mamunul/watertankmonitor/(threads)

Thread 1 (2022-09-21):

add sleep in transmitter

mamunul, 2022-09-21:

mamunul, 2022-10-10:
wake once in every minute and send data, then sleep again. if water level is 4 and motor is on or level is 1 and motor is off then send data in every 15 seconds.

mamunul, 2022-10-11:
For some unknown reason touching the external timer2 crystal only wakes up cpu from power save mode.

mamunul, 2022-12-31:
sleep time is unstable for some reason. after using 32768Hz Crystal without capacitor interval is consistent.

mamunul, 2023-01-02:
15seconds sleep is implemented with 32K crystal un atmega8.

Thread 4 (2022-09-23):

Add test transmitter and receiver to check distance

mamunul, 2022-09-23:
Implement a simplest transmitter using atmega8 and a receiver using esp8266. and take it to the place where it is intended to use so that it can be verified the distance will be ok to communicate wirelessly with reliability.

mamunul, 2022-09-23:
List of the things need to take for testing.

- atmega8
- mini breadboard
- rf transmitter
- 3 battery holder
- esp8266
- rf receiver

mamunul, 2022-10-09:
Testing is completed. It works :). Receiver was connected with my computer in our dining room. Transmitter was moving from receiver to the 3rd floor near water tank. There was no missing information in the receiver, as it prints counter value serially which is received from transmitter.

Closed 2023-06-13.

Thread 7 (2023-01-14):

reduce power consumption in transmitter

mamunul, 2023-01-14:
Now after enabling 15 seconds of power save mode, new battery runs for 2 days only. in every minute there is 4 transmutation and in every transmission there 4 repeated messages. SO in total 16 message per minute. in each message around 15mA is consuming. per minute around 5mA. For normal battery(250mAH) it will withstand for 50 hours only.

**ways to reduce power consumption**

- send 2-3 messages per minute
- reduce avr clock speed to 1MHz from 8MHz

mamunul, 2023-01-15:
add following in transmitter

`#define RCSwitchDisableReceiving`

reduce transmission repeat to 2

` this->setRepeatTransmit(2);`

mamunul, 2023-01-16:
https://arduino.stackexchange.com/questions/50733/is-there-a-way-to-disable-modules-like-adc-without-a-sleep-mode

mamunul, 2023-01-16:
test power consumption using oscilloscope and report here with applied configuration for future reference.

mamunul, 2023-01-19:
transmission repeat to 2 was not working so it kept at 5 and now working.

mamunul, 2023-06-13:
put the atmega in deep-sleep using timer circuit to reduce power more.

mamunul, 2023-10-11:
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

Where:

Bl = Battery lifetime in hours
Bc= Battery capacity in mAh
Ia = Device current consumption when awake in mA
Is = Device current consumption when in Sleep Mode in mA
ta = Time spent awake in seconds (per cycle)
ts = Time spent in Sleep Mode in seconds (per cycle)

mamunul, 2023-10-12:
disable wdt which will keep 1uA consumption down from 15uA

#include <avr/wdt.h>

 wdt_disable();

mamunul, 2023-10-20:
after applying tpl5111 and power down mode, sleep time current consumption is around 11uA and active time consumption is 10mA

mamunul, 2023-10-20:
1. water tank requires around 12minute to fill up.
2.

mamunul, 2023-10-28:
test timer using esp32 interrupt codes to count rather checking in oscilloscope.

mamunul, 2023-10-29:
improve sending performance by reducing repetitive data sending. Check minimum time and similar height.

mamunul, 2023-11-07:
after applying tpl5111, power consumption is significantly reduced, as on sleep transmitter and sensor not taking consuming any power.

mamunul, 2023-11-07:
Now if the circuit don't work under 4 voltage, then a voltage regulator - TPS6320 may be needed to juice out the battery until it is completely depleted.

mamunul, 2023-11-12:
battery is depleted after around 15days. so more optimization is necessary.

mamunul, 2023-11-13:
reduce transmit repetition number and remove delay after sending.
transmit if sensed water level has absolute difference of >= 5cm with the last measured water level, otherwise don't transmit data.

mamunul, 2023-11-14:
after using avr io for powering distance sensor, power consumption is saved in <1uA in sleep time and active time current is 16mA.

mamunul, 2023-11-15:
problems are solved.
to activate sensor power using io, it requires a delay after writing high on the pin - delay(20);less than 18ms not working.
and transmit repetition must be minimum 3, otherwise it won't work.

Now active max current is 8.6mA.

mamunul, 2023-11-15:
received data, when continuous transmission is active(without any sleep or delay).

21:09:02:214 -> received: 168
21:09:02:214 -> 168
21:09:02:362 -> received: 168
21:09:02:362 -> 168
21:09:02:510 -> received: 168
21:09:02:510 -> 168
21:09:02:657 -> received: 168
21:09:02:657 -> 168
21:09:02:805 -> received: 170
21:09:02:805 -> 170
21:09:02:953 -> received: 170
21:09:02:953 -> 170
21:09:03:101 -> received: 170
21:09:03:101 -> 170
21:09:03:248 -> received: 170
21:09:03:248 -> 170
21:09:03:396 -> received: 170
21:09:03:396 -> 170
21:09:03:544 -> received: 170
21:09:03:544 -> 170
21:09:03:691 -> received: 170

Closed 2023-12-12.

Thread 8 (2023-01-19):

add some missing feature in receiver

mamunul, 2023-01-19:
add following feature both in schema and firmware
- jumper to disable/enable buzzer
- button to make buzzer silent
- relay bypass switch so manual on off works
- activate buzzer when tank is empty
- auto shutoff the switch when tank is full

5pins-led
1 INT Pin - receiver
1 INT Pin - relay on/off button(stop buzzer)
1 pin - buzzer out
1 pin - disable/enable buzzer jumper
1 pin - transmitter red led

mamunul, 2023-11-07:
test the circuit and code in project board

mamunul, 2024-01-11:
features are added and tested

Closed 2024-01-11.

Thread 9 (2023-10-23):

Comparison between atmega328 and stm32F103

mamunul, 2023-10-23:

mamunul, 2023-10-23:
**Naming convention of STM32F103**

STM32F103xx family

mamunul, 2023-10-23:
| CHIP         | CPU                  | Freq  | GPIO | Flash | RAM | VCC | Price |
|--------------|----------------------|-------|------|-------|-----|-----|-------|
| ATMEGA328    | 8-bit RISC           | 20MHz | 23   | 32    | 2K  | 5.0 | 1.35$ |
| STM32F103C6T | 32-bit ARM Cortex-M3 | 72MHz | 37   | 32    | 10K | 3.3 | 0.40$ |
| STM32F103VET | 32-bit ARM Cortex-M3 | 72MHz | 80   | 512   | 64K | 3.3 | 1.24$ |

mamunul, 2023-10-23:
| CHIP         | CPU                  | Deep Sleep  Name | DeepSleep uA | DeepSleep Peripherals                                                   | Medium Sleep Name | Medium Sleep uA | Medium Sleep Peripherals                                           | Active mA                    |
|--------------|----------------------|------------------|--------------|-------------------------------------------------------------------------|-------------------|-----------------|--------------------------------------------------------------------|------------------------------|
| ATMEGA328    | 8-bit RISC           | Powerdown        |              | INT0,INT1 level,Watchdog                                                | powersave         |                 | INT0,INT1 level, Watchdog, Timer                                   | 5mA-8Mhz                     |
| STM32F103C6T | 32-bit ARM Cortex-M3 | Standby          | 2uA          | external reset (NRST pin), IWDG reset, rising edge(WKUP pin), RTC alarm | Stop              | 20uA            | EXTI - 16 external the PVD output,  the RTC alarm,  the USB wakeup | 5mA-8MHz 1mA-1MHz 64Mhz      |
| STM32F103VET | 32-bit ARM Cortex-M3 | Standby          | 2uA          | external reset (NRST pin), IWDG reset, rising edge(WKUP pin), RTC alarm | Stop              | 20uA            | EXTI - 16 external the PVD output,  the RTC alarm,  the USB wakeup | 5mA-8MHz 1mA-1MHz 20mA-64MHz |

Thread 10 (2023-11-15):

study on transceiver

mamunul, 2023-11-15:

mamunul, 2023-11-15:
It is difficult to find a better comparison data on transceiver, random data is collected. According to those data RXB6 is best.

| Model              | VCC     | Imax | Range  | dBm     | Freq   | price      | Tx Module |
|--------------------|---------|------|--------|---------|--------|------------|-----------|
| RXB6               | 3-5.5V  | 6mA  | 15-20m | -116dBm | 433MHz | 2.10$      |           |
| SRX882             |         |      | <5m    |         | 433MHz |            |           |
| xy-mk-5v(MX-RM-5V) | 5V      | 4mA  | <5m    | -105dBm | 433MHz | 0.59$ Pair | FS1000A   |
| RX470              | 2.2V-5V | 2mA  |        |         | 433MHz | 0.96$ pair |           |
| RX500A             |         |      |        |         | 433MHz |            |           |
| RXB8               |         | 10mA |        | -114dBm | 433MHz |            |           |
| RXB12              |         | 4mA  |        | -115dBm | 433MHz |            |           |
| RXB14              |         | 4mA  |        | -115dBm | 433MHz |            |           |

Thread 11 (2023-11-15):

study on distance sensor

mamunul, 2023-11-15:
https://www.dfrobot.com/blog-1491.html

mamunul, 2023-11-15:
https://protosupplies.com/product/jsn-sr04t-v3-0-waterproof-ultrasonic-range-finder/

mamunul, 2023-11-15:
| Model     | VCC      | Imax | Freq | trigger pulse width | Resolution | distance   | angle | Temp Sensor | price |
|-----------|----------|------|------|---------------------|------------|------------|-------|-------------|-------|
| HC-SR04   | 4.5-5.5V | 15mA | 40K  | >=10uS              | 3mm        | 2cm-400cm  | 15 D  | NA          | 0.8$  |
| US-100    | 4.5-5.5V | 3mA  | 40K  | >=10uS              | 1mm        | 2cm-400cm  | 15 D  | Includes    | 1.6$  |
| JSN-SR04T | 3.0-5.5V | 30mA | 40K  | >=20uS              | 1cm        | 23cm-600cm | 37 D  | NA          | 2.8$  |

mamunul, 2023-12-12:
The US-100 Ultrasonic Range Finder is similar to the HC-SR04 and HY-SRF05 that it includes the same pulse-width interface as one option to interface to it.  This interface requires the microcontroller to initiate a ‘ping’ and measure the time it takes for the ping to come back.  Based on that out and back time period and the estimated speed of sound which varies with air temperature, the distance can be calculated.  Because there is tight timing required, the operation tends to be a blocking operation on the microcontroller but it overall works very well.

More interestingly, the US-100 also adds a serial interface.  When using the serial interface, the microcontroller requests that a measurement be taken and the module takes care of sending and timing the return of the received ping.  It also takes a measurement of the air temperature to determine the current speed of sound (speed of sound varies somewhat with the air temperature) and from that calculates the distance to the object and returns that measured distance in millimeters.  Using the serial interface is easier to implement, non-blocking on the microcontroller and provides a little more accuracy.

There is a header jumper on the back of the module.  If the jumper is installed, the module is in serial mode of communication.  If the jumper is removed, the module is in pulse-width mode and control and measurement is handled by the microcontroller.

Thread 13 (2023-12-06):

fix receiver not working after a long time period of working

mamunul, 2023-12-06:
around a day later, receiver stop to react with the received data. And it is verified, data is received by connecting esp8266 with receiver module and viewing the serial monitor in vscode. So the problem is in the avr code.

To check the issue, debug avr in project board with receiver module and usb to serial adapter to monitor serial printed data from vscode.

mamunul, 2024-01-11:
After testing in project board with atmega8, the problem is not occurring any more. So the problem may be in soldering, as it is done in Vero board.

Closed 2024-01-11.
