mamunul/watertankmonitor/CircuitDesign/SmartwaterTank/receiver_mega8_brd.pdf

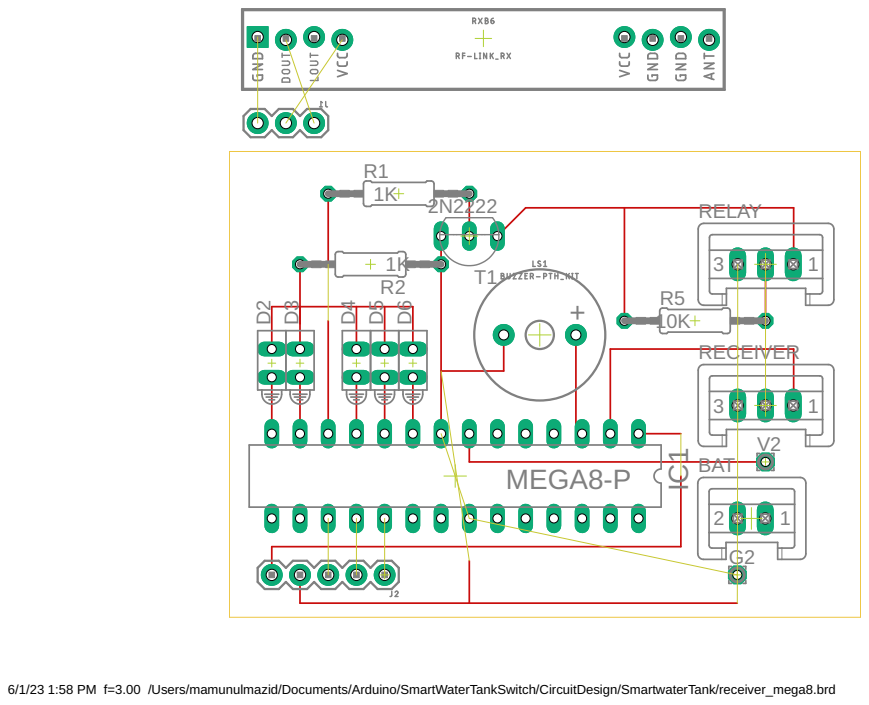
[picture p1: page 1]

6/1/23 1:58 PM f=3.00 /Users/mamunulmazid/Documents/Arduino/SmartWaterTankSwitch/CircuitDesign/SmartwaterTank/receiver_mega8.brd
