mamunul/watertankmonitor/CircuitDesign/SmartwaterTank/receiver_mega8_sch.pdf

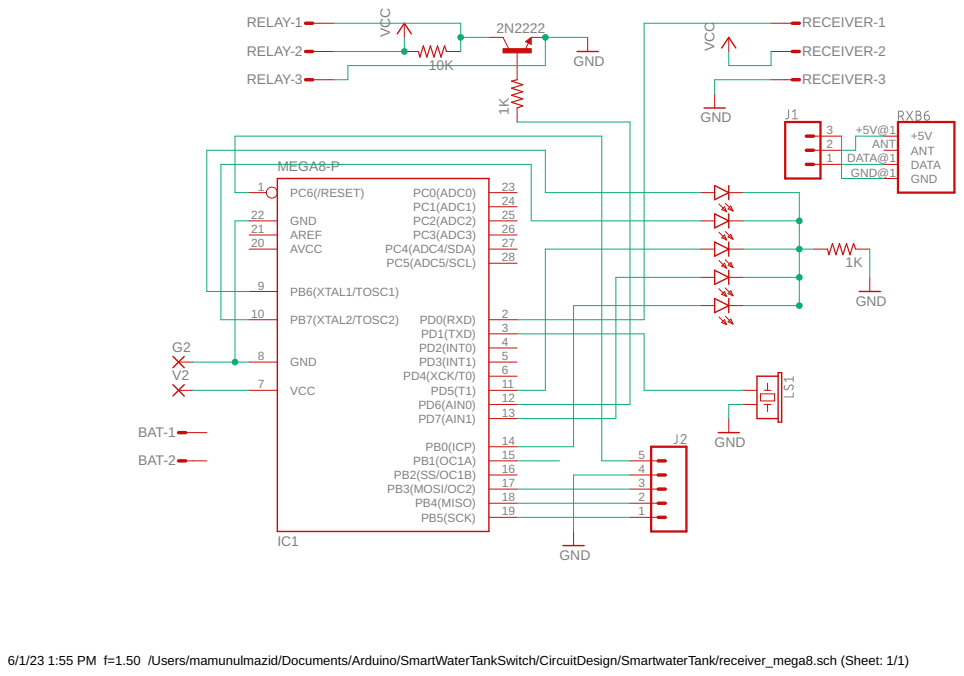
[picture p2: page 1]

6/1/23 1:55 PM f=1.50 /Users/mamunulmazid/Documents/Arduino/SmartWaterTankSwitch/CircuitDesign/SmartwaterTank/receiver_mega8.sch (Sheet: 1/1)
