mamunul/watertankmonitor/CircuitDesign/SmartwaterTank/transmitter_with_sensor_brd.pdf

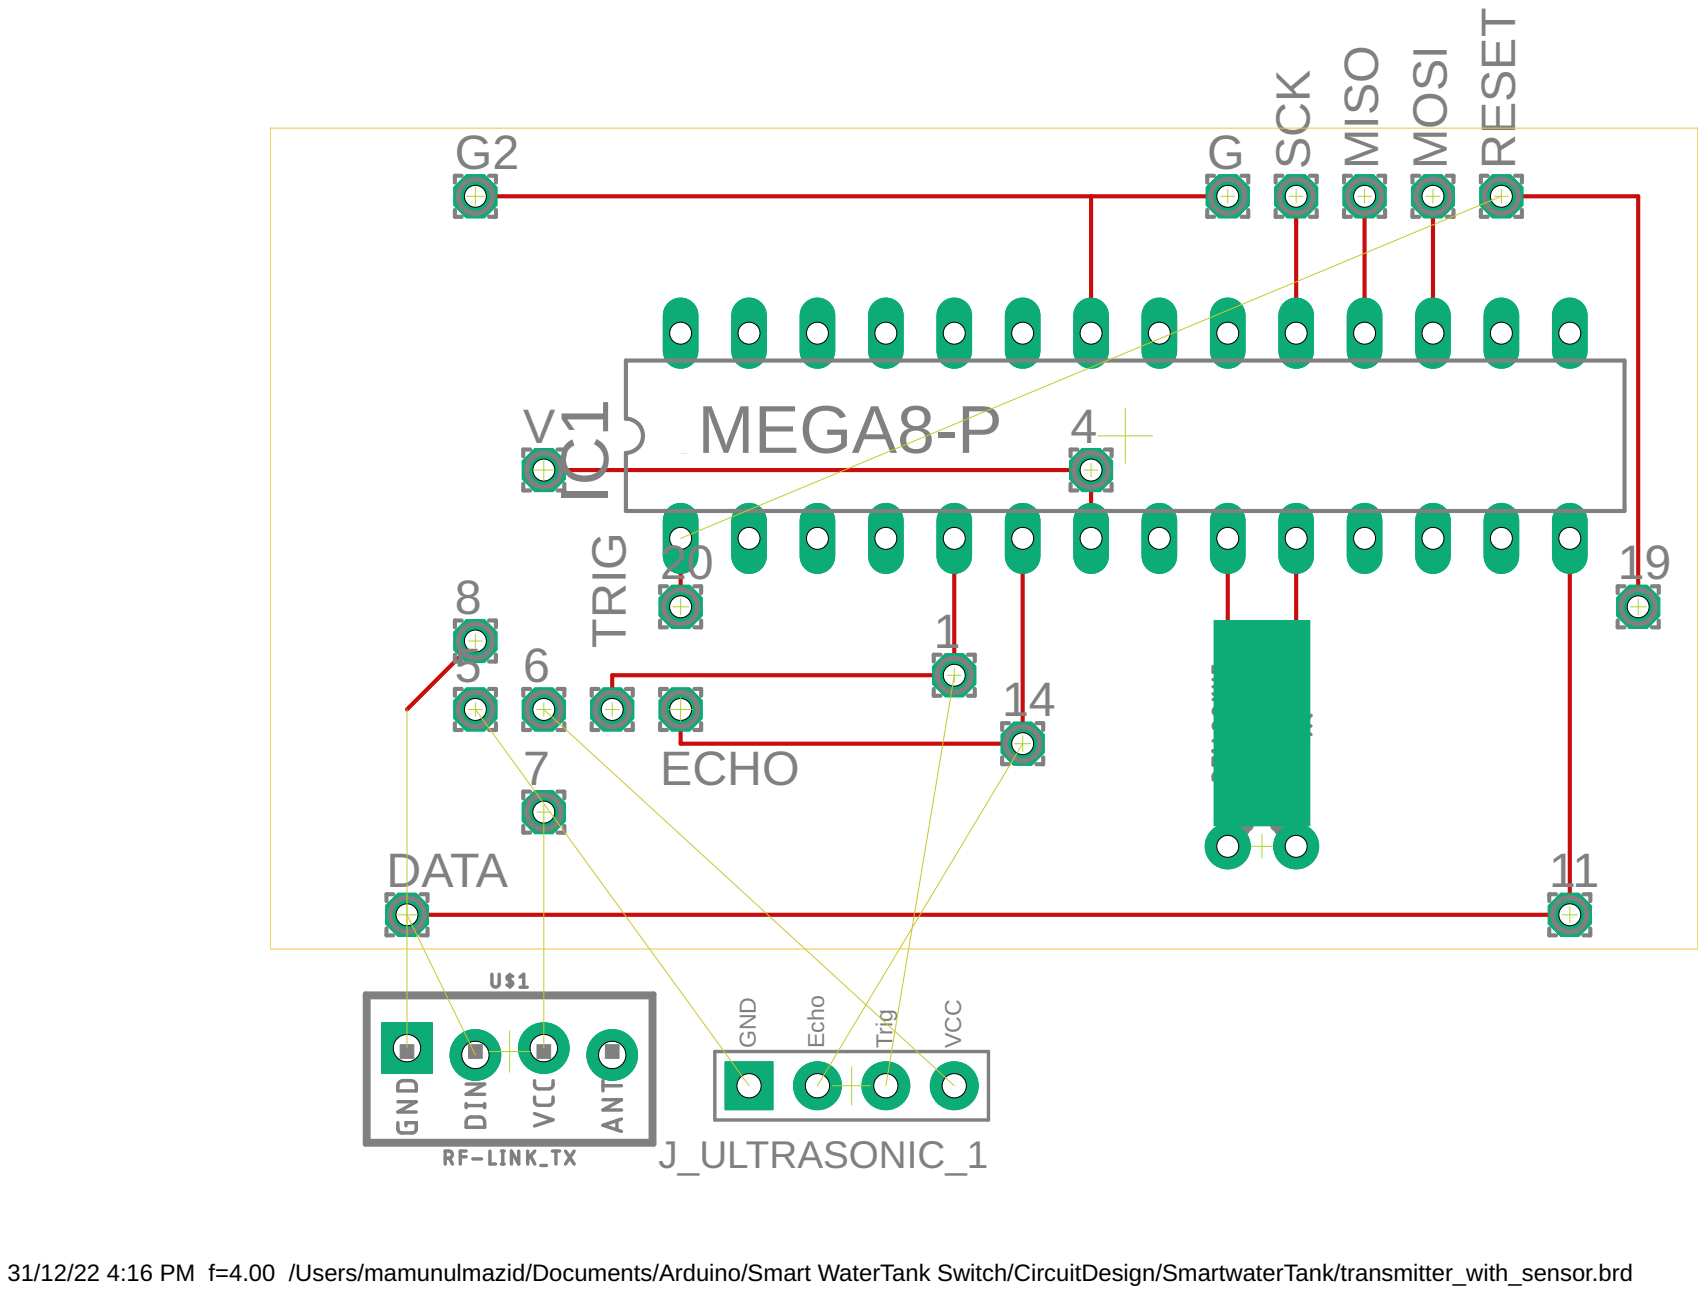
[picture p3: page 1]

31/12/22 4:16 PM f=4.00 /Users/mamunulmazid/Documents/Arduino/Smart WaterTank Switch/CircuitDesign/SmartwaterTank/transmitter_with_sensor.brd
