mamunul/watertankmonitor/CircuitDesign/SmartwaterTank/transmitter_with_sensor_sch.pdf

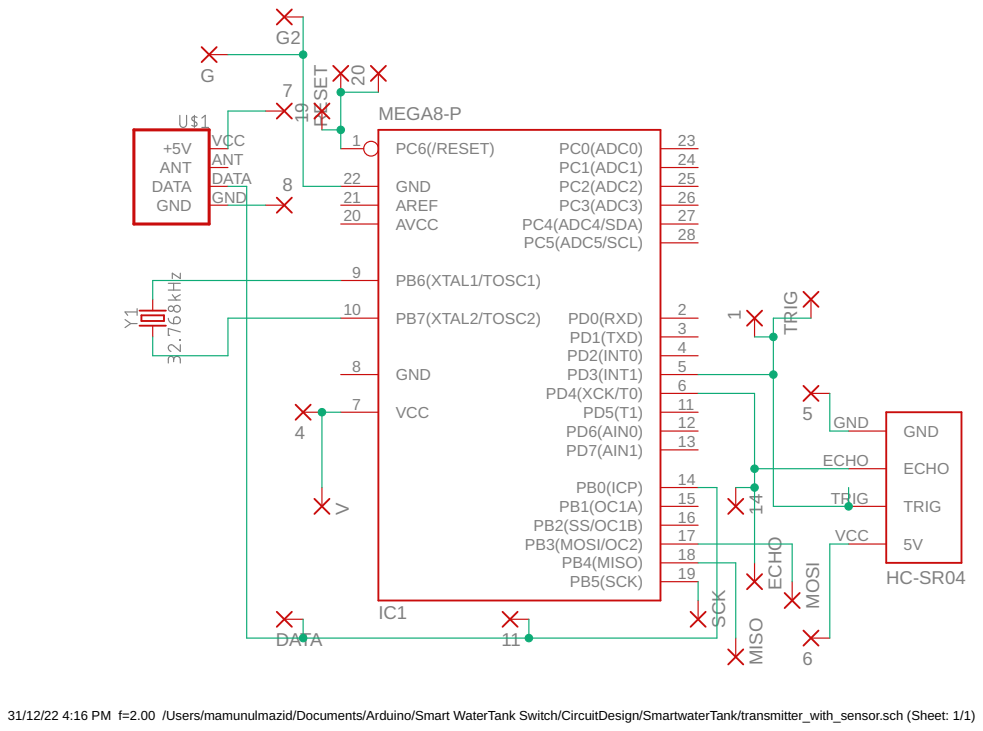
[picture p4: page 1]

PB7(XTAL2/TOSC2) 10

31/12/22 4:16 PM f=2.00 /Users/mamunulmazid/Documents/Arduino/Smart WaterTank Switch/CircuitDesign/SmartwaterTank/transmitter_with_sensor.sch (Sheet: 1/1)
