mamunul/watertankmonitor/CircuitDesign/SmartwaterTank/receiver_mega8.brd

## EAGLE design CircuitDesign/SmartwaterTank/receiver_mega8.brd (2023-01-06)

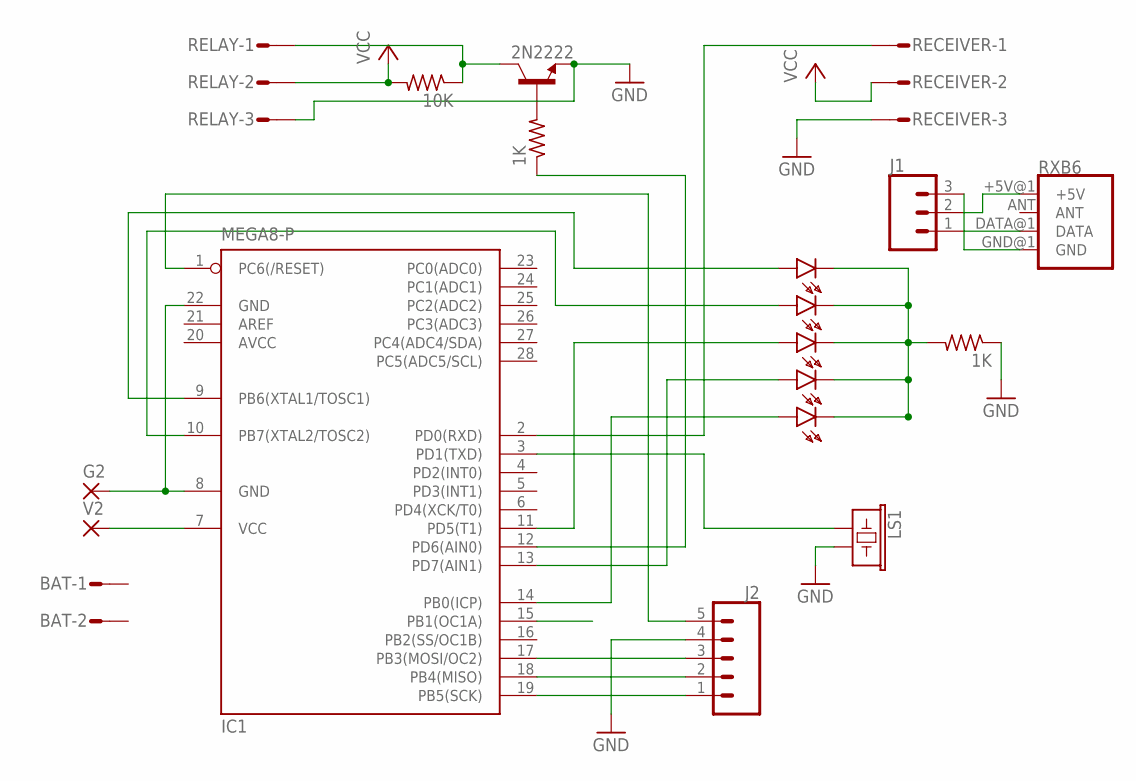
[picture p5: schematic receiver_mega8.sch]

Parts:
BAT: S02P
D2, D3, D4, D5, D6: HLMP6
G2: 1,6/0,8
IC1: MEGA8-P; DIL28-3
J1: CONN_03; 1X03
J2: CONN_05; 1X05
LS1: BUZZER-PTH_KIT; BUZZER-12MM-KIT
R1, R2: 1K; 0207/12
R5: 10K; 0207/12
RECEIVER: S03P
RELAY: S03P
RXB6: RF-LINK_RX
T1: 2N2222; TO92-CBE
V2: 1,6/0,8

Connections:
AVCC: IC1.20 (AVCC)
GND: J2.4, LS1.- (2), R2.1, RECEIVER.3, RELAY.3, T1.E
unnamed: R1.2, T1.B
unnamed: IC1.12 (PD6(AIN0)), R1.1
unnamed: J1.1, RXB6.DATA@1 (DATA)
unnamed: IC1.2 (PD0(RXD)), RECEIVER.1
unnamed: IC1.3 (PD1(TXD)), LS1.+ (1)
unnamed: D2.K, D3.K, D4.K, D5.K, D6.K, R2.2
unnamed: G2.1, IC1.8 (GND), IC1.22 (GND)
unnamed: IC1.7 (VCC), V2.1
unnamed: J1.3, RXB6.GND@1 (GND)
unnamed: D6.A, IC1.9 (PB6(XTAL1/TOSC1))
unnamed: D5.A, IC1.10 (PB7(XTAL2/TOSC2))
unnamed: D4.A, IC1.11 (PD5(T1))
unnamed: D3.A, IC1.13 (PD7(AIN1))
unnamed: J1.2, RXB6.+5V@1 (+5V)
unnamed: D2.A, IC1.14 (PB0(ICP))
unnamed: R5.1, RELAY.1, T1.C
unnamed: IC1.19 (PB5(SCK)), J2.1
unnamed: IC1.18 (PB4(MISO)), J2.2
unnamed: IC1.17 (PB3(MOSI/OC2)), J2.3
unnamed: IC1.1 (PC6(/RESET)), J2.5
VCC: R5.2, RECEIVER.2, RELAY.2

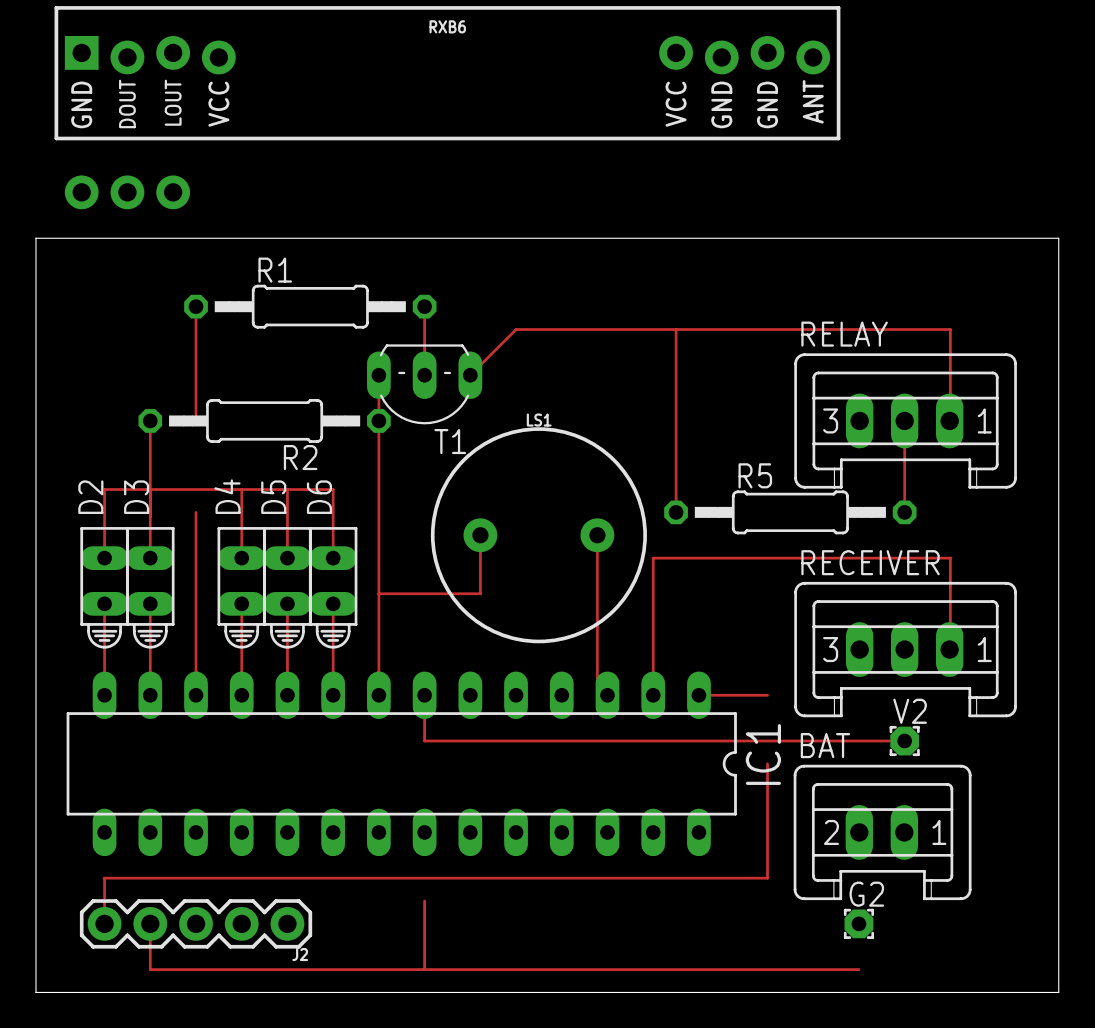
[picture p6: board receiver_mega8.brd from above]

Board: 2 copper layers, 56.8 x 41.9 mm, 19 parts (1 on the bottom side), 22 nets.
