mamunul/watertankmonitor/CircuitDesign/SmartwaterTank/receiver.brd

## EAGLE design CircuitDesign/SmartwaterTank/receiver.brd (2023-01-02)

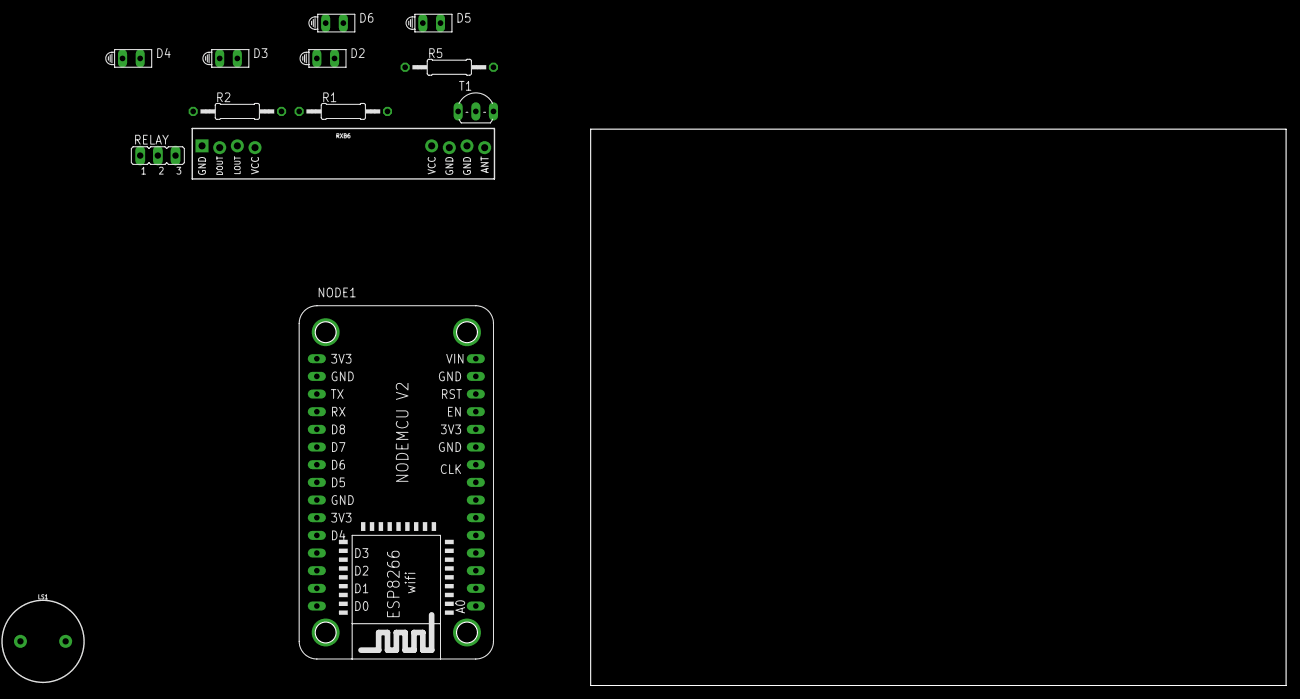
[picture p7: board receiver.brd from above]

Board: 2 copper layers, 100.0 x 80.0 mm, 13 parts (0 on the bottom side), 14 nets, no tracks yet.

Parts:
D2, D3, D4, D5, D6: HLMP6
LS1: BUZZER-PTH_KIT; BUZZER-12MM-KIT
NODE1: NODEMCU_ESP8266
R1, R2: 1K; 0207/12
R5: 10K; 0207/12
RELAY: JP2
RXB6: RF-LINK_RX
T1: 2N2222; TO92-CBE

Connections:
3V3: NODE1.3V3@1, NODE1.3V3@2, NODE1.3V3@3
GND: LS1.-, NODE1.GND@1, NODE1.GND@2, NODE1.GND@3, NODE1.GND@4, R2.1, RELAY.3, RXB6.GND@1, T1.E
unnamed: R1.2, T1.B
unnamed: NODE1.D0, R1.1
unnamed: R5.1, RELAY.2, T1.C
unnamed: NODE1.D4, RXB6.DATA@1
unnamed: LS1.+, NODE1.D1
unnamed: D2.K, D3.K, D4.K, D5.K, D6.K, R2.2
unnamed: D6.A, NODE1.D8
unnamed: D5.A, NODE1.D7
unnamed: D4.A, NODE1.D6
unnamed: D3.A, NODE1.D5
unnamed: D2.A, NODE1.D3
VCC: R5.2, RELAY.1, RXB6.+5V@1
