mamunul/watertankmonitor/CircuitDesign/SmartwaterTank/transmitter_with_sensor.brd

## EAGLE design CircuitDesign/SmartwaterTank/transmitter_with_sensor.brd (2022-12-31)

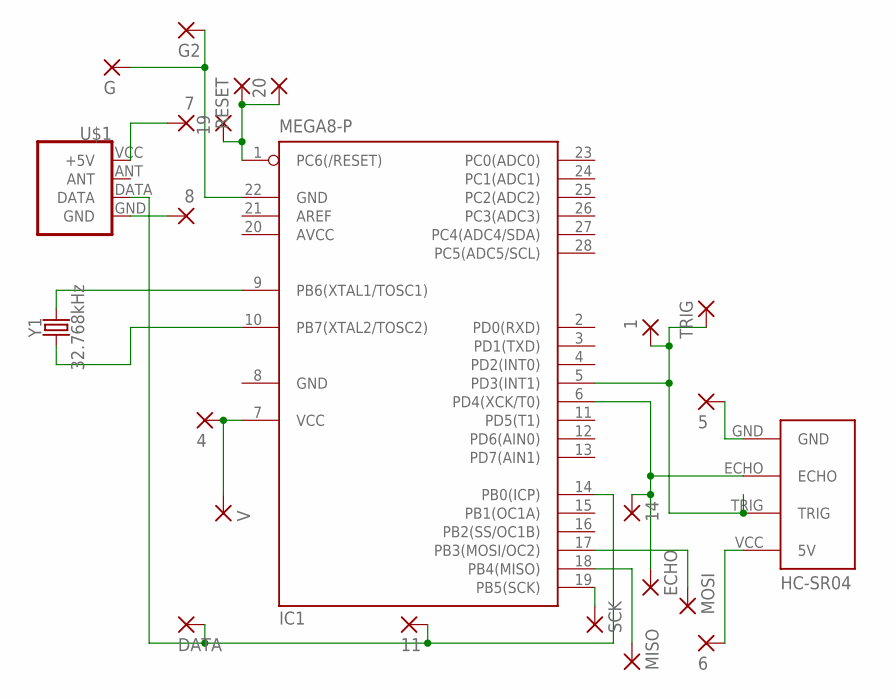
[picture p8: schematic transmitter_with_sensor.sch]

Parts:
1, 4, 5, 6, 7, 8, 11, 14, 19, 20: WIREPAD1,6/0,8; 1,6/0,8
DATA: WIREPAD1,6/0,8; 1,6/0,8
ECHO: WIREPAD1,6/0,8; 1,6/0,8
G, G2: WIREPAD1,6/0,8; 1,6/0,8
IC1: MEGA8-P; DIL28-3
J_ULTRASONIC_1: HC-SR04; HC-SR04_FOOTPRINT
MISO: WIREPAD1,6/0,8; 1,6/0,8
MOSI: WIREPAD1,6/0,8; 1,6/0,8
RESET: WIREPAD1,6/0,8; 1,6/0,8
SCK: WIREPAD1,6/0,8; 1,6/0,8
TRIG: WIREPAD1,6/0,8; 1,6/0,8
U$1: RF-LINK_TX
V: WIREPAD1,6/0,8; 1,6/0,8
Y1: 32.768kHz; CRYSTAL-PTH-2X6-CYL

Connections:
AVCC: IC1.20 (AVCC)
GND: IC1.8 (GND)
unnamed: 6.1, J_ULTRASONIC_1.VCC (5V)
unnamed: G.1, G2.1, IC1.22 (GND)
unnamed: 4.1, IC1.7 (VCC), V.1
unnamed: 5.1, J_ULTRASONIC_1.GND
unnamed: 8.1, U$1.GND
unnamed: 7.1, U$1.VCC (+5V)
unnamed: IC1.9 (PB6(XTAL1/TOSC1)), Y1.2
unnamed: IC1.10 (PB7(XTAL2/TOSC2)), Y1.1
unnamed: 19.1, 20.1, IC1.1 (PC6(/RESET)), RESET.1
unnamed: 14.1, ECHO.1, IC1.6 (PD4(XCK/T0)), J_ULTRASONIC_1.ECHO
unnamed: 1.1, IC1.5 (PD3(INT1)), J_ULTRASONIC_1.TRIG, TRIG.1
unnamed: IC1.17 (PB3(MOSI/OC2)), MOSI.1
unnamed: IC1.18 (PB4(MISO)), MISO.1
unnamed: 11.1, DATA.1, IC1.14 (PB0(ICP)), U$1.DATA
unnamed: IC1.19 (PB5(SCK)), SCK.1

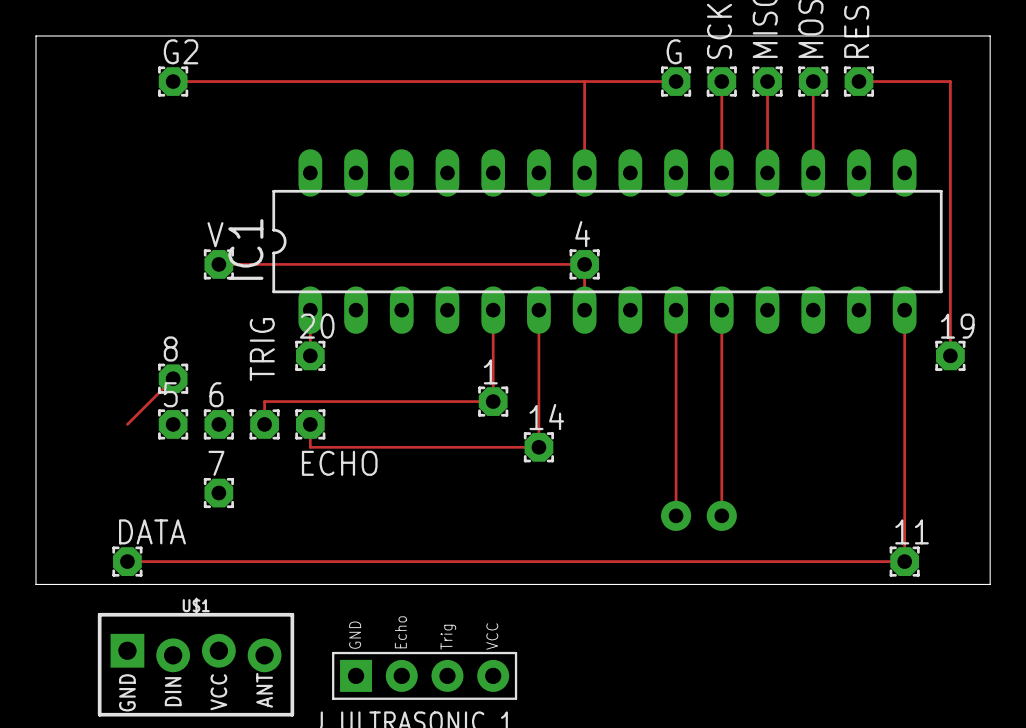
[picture p9: board transmitter_with_sensor.brd from above]

Board: 2 copper layers, 53.0 x 30.5 mm, 24 parts (1 on the bottom side), 15 nets.
