mamunul/watertankmonitor/CircuitDesign/SmartwaterTank/transmitter.brd

## EAGLE design CircuitDesign/SmartwaterTank/transmitter.brd (2022-09-23)

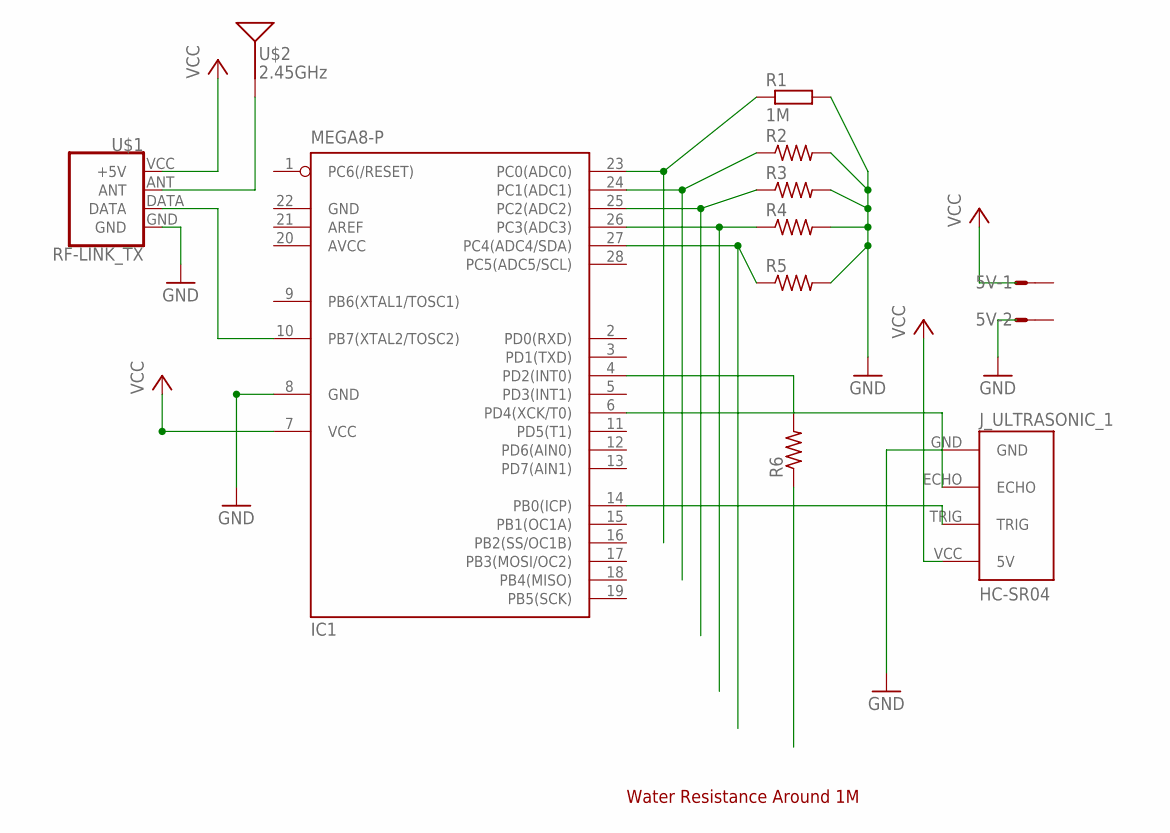
[picture p10: schematic transmitter.sch]

Parts:
5V: S02P
IC1: MEGA8-P; DIL28-3
J_ULTRASONIC_1: HC-SR04; HC-SR04_FOOTPRINT
R1: 1M; 0204/7
R2, R3, R4, R5, R6: R-US_0204/2V; 0204V
U$1: RF-LINK_TX
U$2: 2.45GHz; ANT-2.4GHZ-6.5X2.2MM

Connections:
AVCC: IC1.20 (AVCC)
GND: IC1.8 (GND), IC1.22 (GND), J_ULTRASONIC_1.GND, R1.2, R2.2, R3.2, R4.2, R5.2, U$1.GND
unnamed: IC1.23 (PC0(ADC0)), R1.1
unnamed: IC1.26 (PC3(ADC3)), R4.1
unnamed: IC1.25 (PC2(ADC2)), R3.1
unnamed: IC1.24 (PC1(ADC1)), R2.1
unnamed: IC1.27 (PC4(ADC4/SDA)), R5.1
unnamed: IC1.10 (PB7(XTAL2/TOSC2)), U$1.DATA
unnamed: U$1.ANT, U$2.FEED
unnamed: IC1.4 (PD2(INT0)), R6.2
unnamed: IC1.6 (PD4(XCK/T0)), J_ULTRASONIC_1.ECHO
unnamed: IC1.14 (PB0(ICP)), J_ULTRASONIC_1.TRIG
VCC: IC1.7 (VCC), J_ULTRASONIC_1.VCC (5V), U$1.VCC (+5V)

Notes on the sheet:
Water Resistance Around 1M

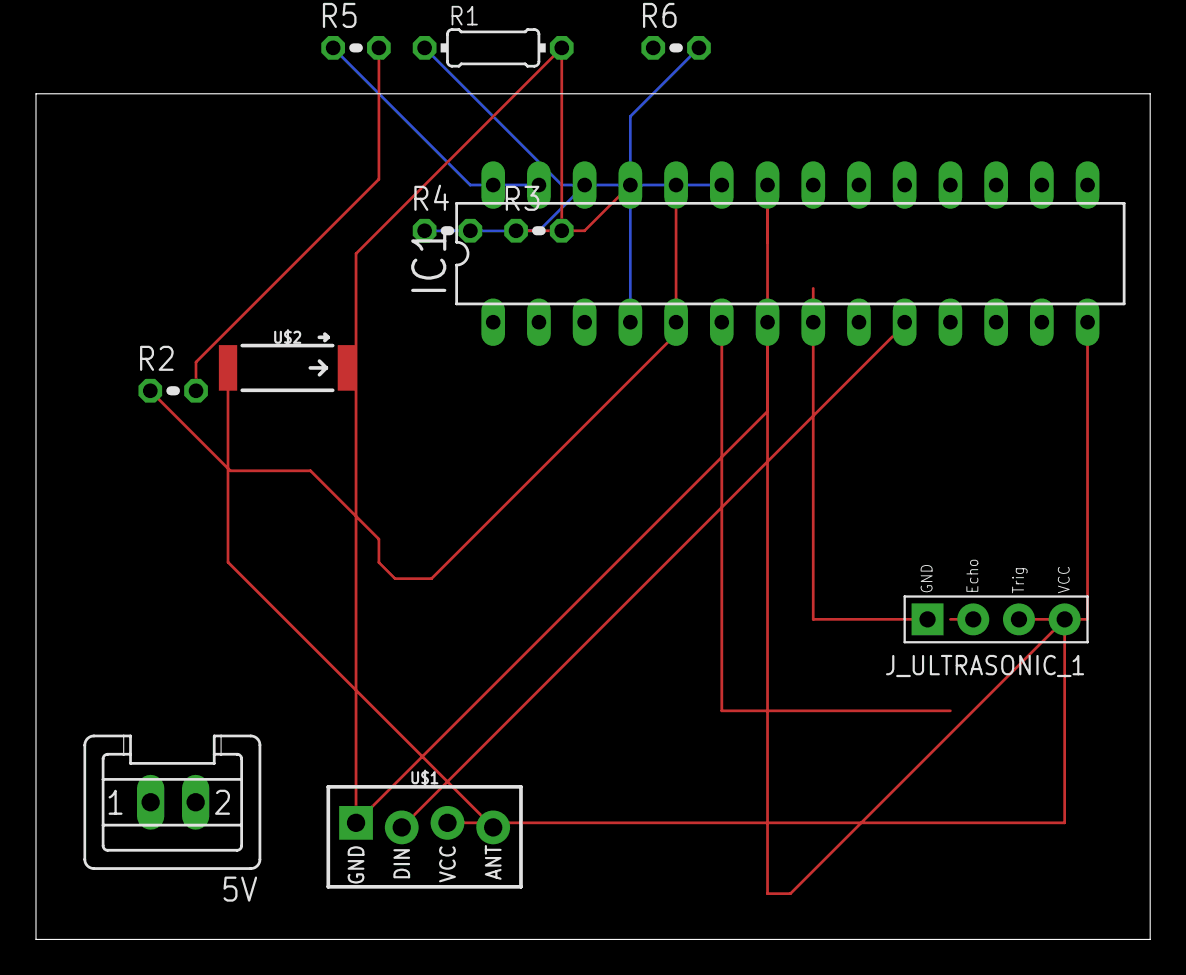
[picture p11: board transmitter.brd from above]

Board: 2 copper layers, 11 parts (0 on the bottom side), 12 nets.
