mamunul/watertankmonitor/Receiver/WaterLevelReceiver-Mega8/pin_map.h

int level1 = PIN_PD0;
int level2 = PIN_PD1;
int level3 = PIN_PD2;
int level4 = PIN_PD3;
int level5 = PIN_PD4;

int ReceivePIN = PIN_PD5;
int switchRelay = PIN_PD6;
int buzzerPin = PIN_PD7;  //GPIO_ID_PIN(1);
