mamunul/watertankmonitor/(commit log)

2022-08-03 rename pin no
2022-08-14 receive water tank levels and toggle relay switch
2022-08-28 add buzzer and relay operation when the water motor switches
    [RF433Receiver.ino, WaterLevelReceiver-ESP8266.ino]
2022-08-29 add design files
    [receiver.sch, transmitter.sch]
2022-08-30 sync mqtt receive with transmitter data
    [receiver.sch]
2022-09-01 add distance sensor in transmitter
2022-09-03 remove wifi reseting on every startup of the chip
    [WiFiHandler.ino]
2022-09-23 implement distance sensor in water level detection
    [transmitter.brd, transmitter.sch, transmitter_with_sensor.brd, transmitter_with_sensor.sch]
2022-10-11 Issue #1: add sleep mode in transmitter
    [RF433Transmitter.ino, SleepController.ino, WaterLevelNotifier_MegaCore.ino]
2022-10-11 Issue #5: add sleep in receiver, not tested
    [WaterLevelReceiver-ESP8266.ino]
2022-10-17 Issue #5: receive long from transmitter as value exceeds int8
    [RF433Receiver.ino, WaterLevelReceiver-ESP8266.ino]
2022-10-18 Issue #5: update transmitter schema
    [transmitter_with_sensor.brd, transmitter_with_sensor.sch]
2022-11-06 Issue #2: complete transmitter board design for vero board
    [transmitter_with_sensor.brd, transmitter_with_sensor.sch]
2022-11-06 Issue #2: remove unnecessary texts from schematic
    [transmitter_with_sensor.brd, transmitter_with_sensor.sch]
2022-12-31 Issue #1: fix sleep issue - using 32K crystal provides 15s sleep time tested in breadboard
    [DistanceSensor.ino, SleepController.ino, WaterLevelNotifier_MegaCore.ino]
2022-12-31 Issue #2: update pcb design
2022-12-31 Issue #2: update schema and board
    [transmitter_with_sensor.brd, transmitter_with_sensor.sch]
2023-01-02 Issue #6: add receiver schema for atmega8
    [receiver.brd, receiver_mega8.brd, receiver_mega8.sch]
2023-01-02 Issue #6: refactor receiver code
    [MQTTTransceiver.cpp, MQTTTransceiver.h, OTA.cpp, RF433Receiver.cpp, WaterLevelReceiver-ESP8266.ino, WiFiHandler.cpp]
2023-01-03 Issue #6: add receiver code for atmega8
    [MQTTTransceiver.cpp, MQTTTransceiver.h, OTA.cpp, RF433Receiver.cpp, Sleep8266.cpp]
2023-01-06 Issue #6: update receiver board for vero board
    [receiver_mega8.brd, receiver_mega8.sch]
